nayetdet/playboyzinho/relatorio/relatorio.pdf

# Projeto de Videogame Portátil com ESP32-S3

### Componentes, arquitetura e conexões elétricas

### Isaac da Cunha Cavalcanti Duarti Jhonny Cunha Simões João Pedro Moreira Campos de Lima

### Ciência da Computação – IFCE Campus Maracanaú Disciplina de Microcontroladores 22 de outubro de 2026

Resumo

Este relatório apresenta um videogame portátil baseado no ESP32-S3 N16R8, com display TFT de 2,8 polegadas, armazenamento em cartão SD, oito botões e reprodução de áudio. O sistema é alimentado por uma bateria de lítio de 3,7 V e 1000 mAh, associada a um carregador TP4056, um conversor elevador MT3608 e uma chave liga/desliga. São descritos os componentes, suas funções, a distribuição da alimentação e o mapeamento das interfaces digitais. A documentação elétrica e física do projeto é desenvolvida no KiCad, por meio do esquemático, das bibliotecas de componentes e do layout da placa de circuito impresso.

## 1 Introdução e objetivo

O projeto consiste em um console portátil e recarregável destinado à execução de um jogo desenvolvido pela equipe. O ESP32-S3 concentra o processamento: recebe os comandos do usuário, atualiza o estado do jogo, controla a apresentação gráfica e transmite os dados de áudio. A tela apresenta os elementos visuais, enquanto o alto-falante reproduz efeitos sonoros e músicas. O cartão SD oferece armazenamento removível para os recursos utilizados pelo sistema.
A entrada dos comandos do jogo ocorre por oito botões físicos. A bateria fornece autonomia em relação à rede elétrica, e o carregador permite a recarga por USB. A chave SW9 atua no caminho de alimentação dos circuitos do videogame, enquanto SW10 habilita ou desliga internamente o amplificador.

## 2 Componentes e funções

### 2.1 ESP32-S3 N16R8

Placa de desenvolvimento com módulo ESP32-S3, 16 MB de flash e 8 MB de PSRAM. É responsável pelo processamento do jogo e pelas interfaces de entrada, vídeo, armazenamento e áudio.

### 2.2 Tela TFT de 2,8 polegadas

Módulo de exibição com comunicação SPI, interface de touch e conector para cartão SD. A tela constitui a saída gráfica do console; o touch permanece sem conexão externa.

### 2.3 Cartão SD

Memória removível para imagens, mapas, músicas e outros arquivos. Utiliza o conector integrado ao módulo da tela, com sinais SPI separados dos utilizados pelo display.

### 2.4 Amplificador MAX98357

Amplificador digital classe D que recebe dados de áudio e fornece o sinal de potência para o alto-falante.

### 2.5 Alto-falante

Transdutor identificado no esquemático como 8 Ω e potência nominal de 1 W. Converte o sinal elétrico amplificado em som.

### 2.6 Bateria

Célula de lítio de 3,7 V nominais e capacidade de 1000 mAh, utilizada como fonte de energia portátil.

### 2.7 Carregador TP4056

Módulo de recarga de uma célula de lítio a partir da entrada USB. Possui terminais para a bateria e para a alimentação da carga.

### 2.8 Conversor de tensão MT3608

Conversor CC–CC elevador, responsável pelo barramento de 5 V a partir da tensão da bateria.

### 2.9 Indicador de bateria

Indicador visual de nível da bateria, conectado ao nó de alimentação anterior ao conversor elevador.

### 2.10 SW1 a SW8

Botões momentâneos conectados individualmente aos GPIOs do ESP32-S3, com retorno ao GND.

### 2.11 SW9

Chave SPDT utilizada como liga/desliga, com um contato sem conexão. Interrompe o positivo da alimentação do conversor e do indicador.

### 2.12 SW10

Chave SPDT que conecta o terminal SD/MODE do MAX98357 a 3,3 V ou ao GND, habilitando ou desligando internamente o amplificador. O controle não utiliza um GPIO do ESP32-S3.

### 2.13 Processamento e memória

O ESP32-S3 integra processamento e periféricos de comunicação para sistemas embarca-dos [1]. Na variante N16R8, os 16 MB de flash armazenam o programa e dados persistentes, enquanto os 8 MB de PSRAM ampliam a memória de trabalho disponível para recursos como buffers gráficos e de áudio [2]. O cartão SD complementa essas memórias com armazenamento removível.
As conexões externas do ESP32-S3 distribuem-se entre as interfaces SPI e de áudio digital e as entradas dos botões. Os GPIOs 35, 36 e 37 não possuem conexões externas no esquemático, em correspondência com o uso de PSRAM octal no módulo. Os GPIOs 19 e 20, associados à USB nativa do ESP32-S3, também permanecem sem ligação aos periféricos do console [1, 2]. O GPIO11 permanece sem conexão externa, pois a habilitação do amplificador é realizada por SW10.

### 2.14 Arquitetura funcional

Botões −→ GPIOs −→ ESP32-S3

ESP32-S3 SPI separado
−−−−−−−→ TFT e cartão SD

ESP32-S3 áudio digital
−−−−−−−→ MAX98357 −→ falante

O sistema reúne entrada, processamento, saída gráfica, saída sonora e armazenamento. O display e o cartão SD utilizam barramentos SPI separados, cada um com seus sinais de clock, dados e seleção. O áudio utiliza sinais próprios de comunicação digital, e SW10 controla a habilitação do amplificador.

## 3 Alimentação e recarga

### 3.1 Distribuição de energia

A alimentação parte da bateria e alcança os demais circuitos por meio dos terminais de saída do módulo carregador e da chave SW9. O conversor de tensão eleva a tensão para o barramento de 5 V. A placa de desenvolvimento ESP32-S3 recebe esse barramento em sua entrada 5V e dispõe de alimentação regulada de 3,3 V.

USB −→ TP4056 ←→ bateria

OUT+ do carregador −→ SW9 −→ MT3608

MT3608: 5 V −→ ESP32-S3, TFT e amplificador

Placa ESP32-S3: 3,3 V −→ LED do TFT e contato 3 de SW10

A rede +BATT conecta o positivo da bateria ao terminal B+ do carregador, e a rede -BATT conecta seu negativo a B–. Os terminais OUT+ e OUT– constituem a conexão da carga ao módulo. OUT– estabelece o GND do console, compartilhado pelo conversor, ESP32-S3, tela, amplificador, indicador e botões.
As redes B– e OUT– são distintas no esquemático. Essa separação é característica da conexão externa de módulos que realizam a proteção pelo caminho negativo da bateria. A função de carregamento pertence ao TP4056; funções de proteção contra descarga excessiva e curto-circuito dependem dos circuitos adicionais presentes no módulo ou na bateria.

### 3.2 Chave liga/desliga e indicador

O terminal comum 2 de SW9 conecta-se a OUT+ do carregador TP4056, pino 1. O contato 3 conecta-se a VIN+ do MT3608, pino 3, e a BAT+ do indicador de bateria, pino 2, enquanto o contato 1 permanece sem conexão. A ligação entre 2 e 3 alimenta o conversor e o indicador; a posição entre 2 e 1 interrompe esse caminho. O terminal BAT– do indicador, pino 1, está ligado ao GND.
A chave atua sobre a carga, mantendo a conexão entre bateria e carregador. Dessa forma, a bateria pode ser recarregada com os circuitos do console desligados. O indicador acompanha a tensão disponível antes da elevação para 5 V, fornecendo uma indicação aproximada do nível de carga.

### 3.3 Conversão de tensão

O MT3608 é um conversor elevador de tensão [5]. No projeto, VIN+ recebe a alimentação comutada da bateria, VIN– e VOUT– estão ligados ao GND e VOUT+ pertence à rede +5V. Essa rede alimenta o ESP32-S3, o VCC do display e o VIN do amplificador.
A elevação de tensão implica uma corrente de entrada superior à corrente fornecida na saída, considerando a mesma potência e as perdas de conversão. Para rendimento η, tensão de bateria Vbat e corrente total I5V :

Ibat ≃

5 I5V

η Vbat

Como exemplo teórico, uma carga de 0,5 A em 5 V, com bateria em 3,7 V e rendimento de 85%, corresponde a aproximadamente 0,80 A na entrada. O consumo efetivo varia com a atividade do processador, os acessos ao cartão, a iluminação da tela e a reprodução sonora.

### 3.4 Carregamento da bateria

A entrada USB do módulo TP4056 fornece energia ao circuito de recarga. Os terminais IN+ e IN– não possuem fios externos no esquemático, pois a alimentação de recarga é realizada pelo conector do próprio módulo.
O TP4056 aplica o processo de corrente constante e tensão constante para uma célula de lítio, com tensão final de 4,2 V na versão documentada. A corrente de carga é estabelecida por um resistor de programação [4]. O valor desse resistor não é representado no símbolo do módulo utilizado no projeto.
O carregador é linear, e sua dissipação pode ser aproximada por P ≃ (VUSB−Vbat)Icarga. Para entrada de 5 V, bateria em 3,7 V e corrente de 0,5 A, essa expressão resulta em 0,65
W. Trata-se de um exemplo teórico de dissipação.
A topologia representada não inclui um circuito dedicado de compartilhamento de alimentação, denominado power path. A recarga com SW9 aberta mantém o consumo do console separado do processo de carga. Em carregadores com término por corrente, o consumo simultâneo de uma carga ligada à bateria pode interferir na identificação do final da recarga [6].

### 3.5 Energia e autonomia teórica

A energia nominal da bateria é aproximadamente:

Ebat = 3,7 V × 1,0 Ah = 3,7Wh.

Para um rendimento ilustrativo de 85% no elevador, a autonomia teórica em horas é:

t ≃

3,7 × 0,85
5 I5V

Corrente em 5 V Potência Autonomia teórica

0,30 A | 1,50 W | 2,10 h
0,50 A | 2,50 W | 1,26 h
0,70 A | 3,50 W | 0,90 h

Os valores representam cenários de cálculo, sem medições de consumo do console. A autonomia real depende da capacidade útil da célula, do limite de descarga, da eficiência dos reguladores e do perfil de uso.

## 4 Display e armazenamento

### 4.1 Conexões dos barramentos SPI

O display e o cartão SD utilizam sinais MOSI, MISO e SCK separados. A linha MOSI transporta dados do ESP32-S3 ao periférico; MISO transporta os dados de retorno; e SCK fornece o clock de comunicação. Cada dispositivo possui sua linha de seleção, conforme o mapeamento a seguir. Os dois conjuntos de terminais pertencem ao módulo U4.

Rede | GPIO | Destino na tela
TFT_MOSI | 18 | SDI (MOSI) do TFT, pino 6.
TFT_MISO | 16 | SDO (MISO) do TFT, pino 9.
TFT_SCK | 15 | Clock do TFT, pino 7.
TFT_CS | 10 | Seleção do TFT, pino 3.
TFT_DC | 8 | Seleção comando/dado do TFT, pino 5.
TFT_RESET | 9 | Reset do controlador da tela, pino 4.
SD_MOSI | 6 | MOSI do cartão SD, pino 16.
SD_MISO | 5 | MISO do cartão SD, pino 17.
SD_SCK | 4 | Clock do cartão SD, pino 18.
SD_CS | 7 | Seleção do cartão SD, pino 15.

A seleção do TFT ocorre pela rede TFT_CS, ligada ao GPIO10, enquanto a seleção do SD utiliza SD_CS, ligada ao GPIO7. As seleções são ativas em nível baixo. As linhas MISO também são independentes: GPIO16 para o TFT e GPIO5 para o SD.
O sinal DC distingue comandos de dados enviados ao controlador gráfico. RESET controla a reinicialização do display por um GPIO próprio, sem conexão ao reset geral da placa ESP32-S3. A escolha de GPIOs para SPI utiliza os recursos de roteamento dos sinais periféricos do microcontrolador [1].

### 4.2 Alimentação da tela e interface de touch

O VCC da tela, pino 1, está ligado ao barramento de 5 V. O terminal LED, pino 8, está ligado à rede de 3,3 V da placa ESP32-S3, e o pino 2 está conectado ao GND. VCC corresponde à alimentação do módulo, enquanto LED é o terminal associado à iluminação da tela. As tensões dessas redes são distintas dos níveis lógicos de comunicação do ESP32-S3, que utiliza sinais de 3,3 V.
O esquemático identifica o módulo como TFT de 2,8 polegadas com touch. O símbolo apresenta seus terminais externos, sem especificar o controlador gráfico, a resolução ou o circuito interno de alimentação e iluminação.
Os sinais T_CLK, T_CS, T_DIN, T_DO e T_IRQ, correspondentes aos pinos 10 a 14, permanecem sem ligação externa. Portanto, a interface de touch não participa da entrada de comandos. Os terminais SD_CS, SD_MOSI, SD_MISO e SD_SCK correspondem à interface do cartão de memória integrado ao módulo.

## 5 Subsistema de áudio

O áudio é transmitido do ESP32-S3 ao módulo MAX98357 por três sinais: DIN transporta as amostras, BCLK determina o ritmo dos bits e LRC identifica os canais e a cadência das amostras.

Rede GPIO Destino no amplificador

DIN | 12 | DIN, pino 3
BCLK | 13 | BCLK, pino 2
LRC | 14 | LRC/LRCLK, pino 1

O MAX98357A recebe áudio no formato I²S e não exige clock mestre MCLK. O MAX98357B utiliza o formato justificado à esquerda [3]. No esquemático, o amplificador recebe 5 V em VIN, pino 7, e sua referência de terra é estabelecida pelo pino 6.
O terminal GAIN, pino 4, permanece sem conexão externa, e sua configuração depende dos componentes presentes no módulo. O terminal SD/MODE, pino 5, pertence à rede AMP_SD, ligada exclusivamente ao terminal comum 2 de SW10. O GPIO11 não participa dessa rede.

### 5.1 Chave de áudio SW10

Terminal de SW10 Rede | Destino
1 | GND | Terra comum
2 (comum) | AMP_SD SD/MODE de U7, pino 5
3 | 3V3 | Saída de 3,3 V de U1, pino 1

A ligação entre 2 e 3 aplica 3,3 V ao SD/MODE e habilita o amplificador, selecionando o canal esquerdo. A ligação entre 2 e 1 aplica GND e coloca o amplificador em desligamento interno [3]. A chave não interrompe o VIN de 5 V; o ESP32-S3 e a tela continuam alimentados. Não há resistor externo nessa ligação. A chave física deve desconectar um contato antes de conectar o outro, e seu terminal comum deve ser identificado conforme o modelo utilizado.
O alto-falante LS1 está identificado no esquemático com impedância nominal de 8 Ω e potência de 1 W. Sua ligação é prevista diretamente no borne do módulo, com fios fixados por parafusos. Os dois pinos de LS1 estão marcados como sem conexão no desenho, acompanhados dessa indicação de montagem. O símbolo do amplificador representa os terminais de alimentação e entrada; o borne de saída não está incluído nessa representação. A saída para o falante é diferencial, entre os dois terminais do amplificador [3]. A relação entre potência, impedância e tensão eficaz diferencial é P = V
| | 2 ef/R. Para 1 W em
8 Ω, essa relação corresponde a aproximadamente 2,83 V eficazes em um sinal senoidal.

## 6 Controles físicos

Cada botão conecta um GPIO ao GND quando pressionado. O uso de sinais individuais permite a identificação independente dos oito comandos, sem uma matriz de varredura. O mapeamento é apresentado a seguir.

Botão Rede | GPIO Outro terminal
SW1 | Button-1 2 | GND
SW2 | Button-2 42 | GND
SW3 | Button-3 41 | GND
SW4 | Button-4 39 | GND
SW5 | Button-5 40 | GND
SW6 | Button-6 38 | GND
SW7 | Button-7 21 | GND
SW8 | Button-8 47 | GND

O GPIO48 está ligado ao LED RGB integrado à placa de desenvolvimento, conforme confirmado por teste de alternância entre vermelho, verde, azul e apagado. Esse pino permanece sem conexão externa no projeto. A distribuição dos botões foi reorganizada para liberar o GPIO48 e acompanhar a sequência das trilhas na PCB.
A lógica de leitura é ativa em nível baixo: com entrada polarizada por pull-up, o botão solto corresponde ao nível 1 e o botão pressionado corresponde ao nível 0. O esquema não apresenta resistores externos de polarização para os botões; o ESP32-S3 dispõe de pull-ups internos configuráveis [1].

Os contatos mecânicos podem apresentar transições breves durante o acionamento, fenômeno conhecido como repique ou bounce. O tratamento desse efeito permite interpretar um acionamento físico como um único comando. A associação dos oito botões às ações do jogo é definida pela lógica da aplicação.

## 7 Documentação e placa de circuito impresso

O projeto utiliza o KiCad para representar as conexões e a disposição física dos componentes. O arquivo playboyzinho.kicad_sch contém o esquemático, e playboyzinho.kicad_pcb contém o layout da placa. A biblioteca lib-do-playboy.kicad_sym e os footprints de lib-do-playboy.pretty representam os módulos e suas interfaces de montagem.
O arquivo da PCB define uma placa com espessura nominal de 1,6 mm, material dielétrico FR4 e duas camadas de cobre, F.Cu e B.Cu. Os footprints correspondem aos módulos de alimentação, processamento, display, áudio e indicador, além dos botões, da chave e da conexão da bateria. Essa estrutura reúne os subsistemas em uma base de interligação física.
As referências dos componentes relacionam os elementos do esquemático aos seus footprints. Os rótulos de rede identificam conexões como TFT_MOSI, SD_SCK, AMP_SD, DIN e Button-1, inclusive quando os trechos correspondentes aparecem afastados no desenho. Os símbolos PWR_FLAG são elementos de documentação elétrica do KiCad associados à indicação de redes alimentadas, sem componente físico correspondente.

## 8 Funcionamento do console

Ao fechar SW9, a alimentação da bateria alcança o conversor elevador e o indicador. O barramento de 5 V alimenta a placa ESP32-S3, a tela e o amplificador. Durante a operação, o processador lê os botões, executa a lógica do jogo, acessa recursos no cartão SD e apresenta as saídas gráficas e sonoras.
A comunicação com a tela e o cartão ocorre por barramentos SPI separados, com seleção individual dos dispositivos. A reprodução de áudio utiliza sua própria interface digital, enquanto SW10 habilita ou desliga internamente o amplificador por SD/MODE. A abertura de SW9 interrompe a alimentação da carga, enquanto a bateria permanece conectada ao módulo carregador.

## 9 Conclusão

O videogame portátil integra processamento, controles físicos, vídeo, armazenamento e áudio em uma plataforma baseada no ESP32-S3 N16R8. A alimentação por bateria, o carregador TP4056 e o conversor MT3608 compõem o subsistema de energia. Os barramentos SPI separados para display e SD e os sinais próprios de áudio organizam a comunicação dos periféricos, enquanto oito GPIOs atendem aos botões. SW9 controla a alimentação geral da carga, e SW10 controla a habilitação do amplificador. O esquemático e o layout desenvolvidos no KiCad documentam as conexões e a integração física dos componentes do console.

## Referências

[1] Espressif Systems. ESP32-S3 Series Datasheet. Pinagem, níveis elétricos e periféricos. https://www.espressif.com/sites/default/files/documentation/esp32-s3_datasheet_en.pdf. (https://www.espressif.com/sites/default/files/documentation/esp32-s3_datasheet_en.pdf)
[2] Espressif Systems. ESP32-S3-WROOM-1 & ESP32-S3-WROOM-1U Datasheet. Varian-tes de memória e restrições de pinos. https://www.espressif.com/sites/default/files/documentation/esp32-s3-wroom-1_wroom-1u_datasheet_en.pdf. (https://www.espressif.com/sites/default/files/documentation/esp32-s3-wroom-1_wroom-1u_datasheet_en.pdf)
[3] Analog Devices. MAX98357A/MAX98357B: Tiny, Low-Cost, PCM Class D Amplifier with Class AB Performance. https://www.analog.com/media/en/technical-documentation/data-sheets/MAX98357A-MAX98357B.pdf. (https://www.analog.com/media/en/technical-documentation/data-sheets/MAX98357A-MAX98357B.pdf)
[4] NanJing Top Power ASIC. TP4056, revisão 2.0. https://www.toppwr.com/uploadfile/file/20230304/640301eae1260.pdf. (https://www.toppwr.com/uploadfile/file/20230304/640301eae1260.pdf)
[5] Aerosemi. MT3608, página do fabricante. https://www.aerosemi.com/forum.php?mod=viewthread&tid=32. (https://www.aerosemi.com/forum.php?mod=viewthread&tid=32)
[6] Microchip Technology. AN1149: Designing a Li-Ion Battery Charger and Load Sharing System. https://www.microchip.com/content/dam/mchp/documents/OTH/ApplicationNotes/ApplicationNotes/01149c.pdf. (https://www.microchip.com/content/dam/mchp/documents/OTH/ApplicationNotes/ApplicationNotes/01149c.pdf)

## A Esquemático do videogame


Esquemático do console com processamento, display, áudio, controles e alimentação.

10
