nayetdet/playboyzinho/kicad/playboyzinho.kicad_pcb

## KiCad design kicad/playboyzinho.kicad_pcb (2026-10-29)

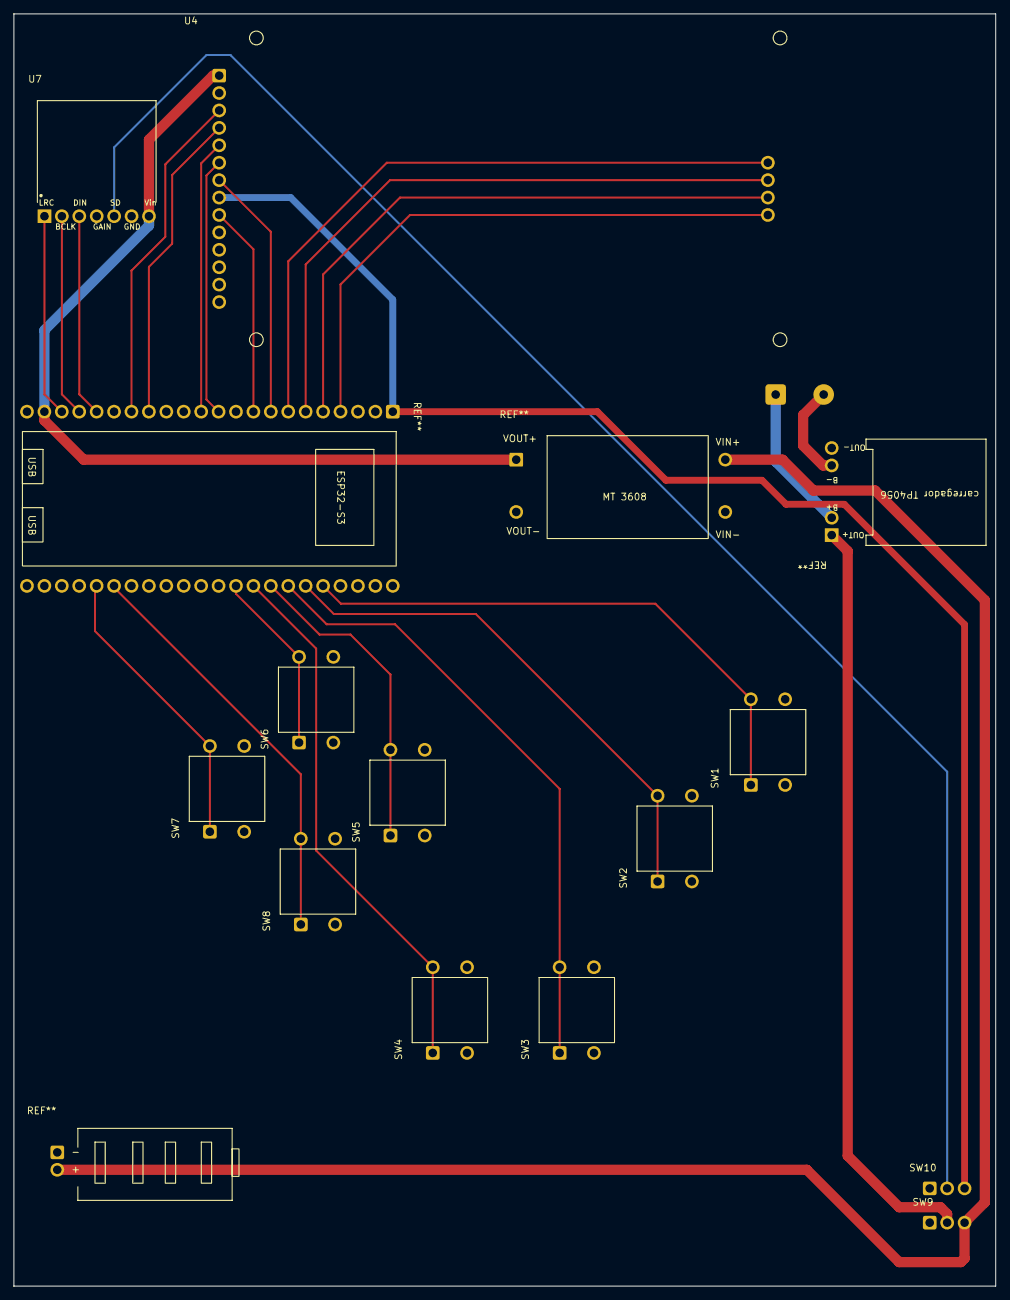
[picture p2: board playboyzinho.kicad_pcb from above]

Board: 2 copper layers, 143.2 x 185.5 mm, 17 parts (1 on the bottom side), 29 nets.

Parts:
SW1, SW2, SW3, SW4, SW5, SW6, SW7, SW8: SW_Push; botao
SW9, SW10: SW_SPDT; alavanca
U1: esp32-s3-pl; esp32-s3
U2: bateria
U3: (dc dc) MT3608
U4: tela TFT 2.8
U5: (carregador) TP4056
U6: indicador-bateria
U7: (amplificador)_MAX98357_Module; (amplificador) MAX98357_Module

Connections:
+5V: U1.21 (5V), U3.1 (VOUT+), U4.1 (VCC), U7.7 (VIN)
+BATT: U2.1 (BAT+), U5.2 (B+)
-BATT: U2.2 (BAT-), U5.3 (B-)
/3V3: SW10.3 (C), U1.1 (3V3), U4.8 (LED)
/AMP_SD: SW10.2 (B), U7.5 (SD)
/BCLK: U1.19 (GPIO13), U7.2 (BCLK)
/Button-1: SW1.1, U1.27 (GPIO2)
/Button-2: SW2.1, U1.28 (GPIO42)
/Button-3: SW3.1, U1.29 (GPIO41)
/Button-4: SW4.1, U1.31 (GPIO39)
/Button-5: SW5.1, U1.30 (GPIO40)
/Button-6: SW6.1, U1.32 (GPIO38)
/Button-7: SW7.1, U1.40 (GPIO21)
/Button-8: SW8.1, U1.39 (GPIO47)
/DIN: U1.18 (GPIO12), U7.3 (DIN)
/LRC: U1.20 (GPIO14), U7.1 (LRC)
/SD_CS: U1.7 (GPIO7), U4.15 (SD_CS)
/SD_MISO: U1.5 (GPIO5), U4.17 (SD_MISO)
/SD_MOSI: U1.6 (GPIO6), U4.16 (SD_MOSI)
/SD_SCK: U1.4 (GPIO4), U4.18 (SD_SCK)
/TFT_CS: U1.16 (GPIO10), U4.3 (CS)
/TFT_DC: U1.12 (GPIO8), U4.5 (DC)
/TFT_MISO: U1.9 (GPIO16), U4.9 (SDO-(MISO))
/TFT_MOSI: U1.11 (GPIO18), U4.6 (SDI-(MOSI))
/TFT_RESET: U1.15 (GPIO9), U4.4 (RESET)
/TFT_SCK: U1.8 (GPIO15), U4.7 (SCK)
GND: SW1.2, SW2.2, SW3.2, SW4.2, SW5.2, SW6.2, SW7.2, SW8.2, SW10.1 (A), U1.22 (GND), U1.23 (GND), U1.43 (GND), U1.44 (GND), U3.2 (VOUT-), U3.4 (VIN-), U4.2 (GND), U5.4 (OUT-), U6.1 (BAT-), U7.6 (GND)
unnamed: SW9.2 (B), U5.1 (OUT+)
unnamed: SW9.3 (C), U3.3 (VIN+), U6.2 (BAT+)
