nayetdet/playboyzinho/(commit log)

2026-08-31 feat: video player
    [partitions.csv]
2026-09-04 feat: cria esquemático do playboyzinho no kicad
    [playboyzinho.kicad_pcb, playboyzinho.kicad_sch]
2026-09-18 feat: adicionando modulo de som no kicad
    [playboyzinho.kicad_sch]
2026-09-18 feat: optimize ESP32 video and audio playback
2026-09-28 feat: atualiza esquemático de acordo com circuito atualmente (28/09/2026, 6:00)
    [playboyzinho.kicad_sch]
2026-09-28 refact: junta um pouco os componentes no esquemático (estavam muito separados)
    [playboyzinho.kicad_sch]
2026-09-29 feat: adiciona lista de conexões, adiciona botões no esquemático, adiciona conexão LED que tava faltando no esquemático, remove imagens desnecessárias
    [playboyzinho.kicad_sch]
2026-10-03 feat: cria novo símbolo para tela e adiciona ele no esquemático, finaliza o geralzão dos footprints (talvez precise de ajustes)
    [playboyzinho.kicad_sch]
2026-10-04 feat: ajustes no esquemático, cria footprint do botão, posiciona elementos no pcb
    [playboyzinho.kicad_pcb, playboyzinho.kicad_sch]
2026-10-04 fix: corrige conexões do esquemático e direção dos pinos de determinados símbolos
    [playboyzinho.kicad_pcb, playboyzinho.kicad_sch]
2026-10-04 refact: altera posição dos pinos dos botões e associa corretamente os footprints na parte de símbolos (antes, estava só no esquemático)
    [playboyzinho.kicad_sch]
2026-10-06 feat: finaliza pcb
    [playboyzinho.kicad_pcb, playboyzinho.kicad_sch]
2026-10-06 fix: corrige indicador de bateria errado e faz pequenos ajustes
    [playboyzinho.kicad_pcb, playboyzinho.kicad_sch]
2026-10-06 fix: corrige lista de conexões no arquivo docs/conexoes.md
    [playboyzinho.kicad_sch]
2026-10-06 refact: ajustes de tamanho do pcb e posicionamento dos botões
    [playboyzinho.kicad_pcb]
2026-10-09 refact: altera par de botões conectados e muda gpios para 0,3mm
    [playboyzinho.kicad_pcb, playboyzinho.kicad_sch]
2026-10-20 refact: muda código para condizer com esquemático (novos pinos para conectar sd e tela separados) e corrige tamanho da tela
2026-10-22 feat: atualiza relatório e arquivo de conexões
2026-10-22 feat: adiciona um sinal de - e + no indicador de bateria
